swholmstead/ForkLift/README.md

<h1>3D printed RC Fork Lift</h1>
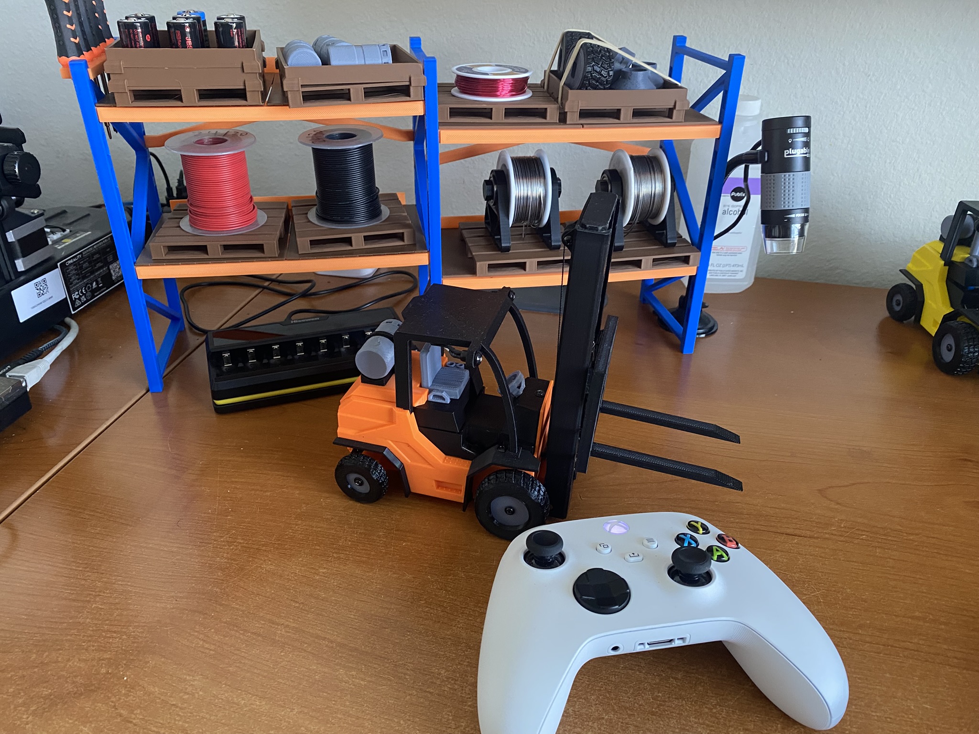
[picture p1: pictures/IMG_3393.JPEG]
Skidsteer


<h2>Table of Contents</h2>

* [3D Models](https://www.printables.com/model/1189510-3d-printed-rc-forklift-updated)
* [Bill of Materials](docs/bom.md)
* [Schematic and Printed Circuit Board](docs/schematics.md)
* [Assembly Instructions](docs/assembly.md)
* [Arduino IDE and Software](docs/arduino.md)

List of supported game controllers can be found here: [https://bluepad32.readthedocs.io/en/latest/supported_gamepads/](https://bluepad32.readthedocs.io/en/latest/supported_gamepads/)
