swholmstead/ForkLift/pictures/IMG_3504.JPEG

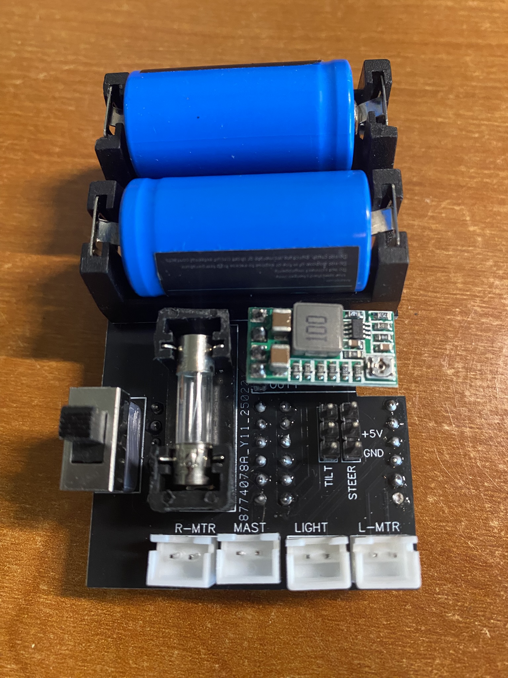
pictures/IMG_3504.JPEG
