swholmstead/ForkLift/docs/bom.md

<h2>Bill of Materials</h2>

All of these components are common and can be found online. I have provided links to Amazon and AliExpress, but these vendors may change over time. If the links don't work, just search for the components from wherever you shop.

* ESP32 WROOM-32 Development Board [Amazon](https://www.amazon.com/dp/B08D5ZD528) [AliExpress](https://www.aliexpress.us/item/3256805767190776.html)
    * This is available with micro USB or USB-C.  Get the one that you like.
* N20 12V 100 RPM motors (qty 3) [Amazon](https://www.amazon.com/gp/product/B0B8DB6NC8) [AliExpress](https://www.aliexpress.us/item/3256806632632389.html)
* 106-2RS bearings 6mm x 10mm (qty 2) [Amazon](https://www.amazon.com/gp/product/B082PPH3Z2)
* 85-2RS bearings 5mm x 8mm (qty 4) [Amazon](https://www.amazon.com/gp/product/B082PRTDZ9)
* 9g Micro Servo (qty 2) - available in metal or plastic.  Both work fine, but metal costs more but is more durable.
    *  SG90 (plastic) [Amazon](https://www.amazon.com/dp/B07Q6JGWNV) [AliExpress](https://www.aliexpress.us/item/3256806097043668.html)
    *  MG90S (metal) [Amazon](https://www.amazon.com/dp/B09BV5D7MD) [AliExpress](https://www.aliexpress.us/item/3256807333354770.html)
* 5V Buck Converter [Amazon](https://www.amazon.com/dp/B0DGPZ91BD) [AliExpress](https://www.aliexpress.us/item/3256807692095306.html)
* DRV8833 H-bridge (qty 2) [Amazon](https://www.amazon.com/dp/B0DB8CX8LK) [AliExpress](https://www.aliexpress.us/item/3256806096142480.html)
* JST-XH connectors (qty 4) [Amazon](https://www.amazon.com/dp/B0D6KSMK1Q) [AliExpress](https://www.aliexpress.us/item/2251832479273592.html)
* SS12D10 SPDT micro slide switch [Amazon](https://www.amazon.com/gp/product/B09R41P1JF) [AliExpress](https://www.aliexpress.us/item/2255800493933955.html)
* PCB Headers 2.54mm pitch [Amazon](https://www.amazon.com/2-54MM-Breakaway-Connector-Arduino-Prototype/dp/B08DVGCTKT) [AliExpress](https://www.aliexpress.us/item/2255800687544049.html)
* BLX-A Fuse holder 5mm x 20mm  (qty 1) [Amazon](https://www.amazon.com/dp/B093FK3GB1) [AliExpress](https://www.aliexpress.us/item/3256808172588255.html)
* 5A Fast-blow fuse 5mm x 20mm  (qty 1) [Amazon](https://www.amazon.com/dp/B07V5MYBL1) [AliExpress](https://www.aliexpress.us/item/3256803802728124.html)
* CR123a battery holder (qty 2) [Amazon](https://www.amazon.com/gp/product/B08RD1KQN3) [AliExpress](https://www.aliexpress.us/item/3256806203437629.html)
* CR123a rechargeable batteries (qty 2)
    * You can buy the batteries plus a charger [Amazon](https://www.amazon.com/dp/B0CF1SXDZ1)
    * Or get the ones with a built in charger [Amazon](https://www.amazon.com/dp/B0D3H7PBK8)
* 3mm 12V LED lights [Amazon](https://www.amazon.com/dp/B07T9KX9BP) [AliExpress](https://www.aliexpress.us/item/3256803264288460.html)
* 3mm LED holder [Amazon](https://www.amazon.com/dp/B07NRWLWCP) [AliExpress](https://www.aliexpress.us/item/3256803821521152.html)
* M2.6 x 6mm self-tapping pan head screws [Amazon](https://www.amazon.com/dp/B08QF455PJ) [AliExpress](https://www.aliexpress.us/item/3256806345826640.html)
* M2.6 x 8mm self-tapping pan head screws [Amazon](https://www.amazon.com/dp/B08QF455PJ) [AliExpress](https://www.aliexpress.us/item/3256806345826640.html)
* T270 or #277 or 840D upholstery thread for mast [Amazon](https://www.amazon.com/dp/B09NBCZLZY)
