swholmstead/ForkLift/docs/assembly.md

<h2>Assembly Instructions</h2>

<h3>Mast</h3>

Attach pulleys to mast sections with M2.6 x 6mm screws.  Ensure that pulleys swivel easily.  You may have to drill out outer holes to ensure that screws roll easily.

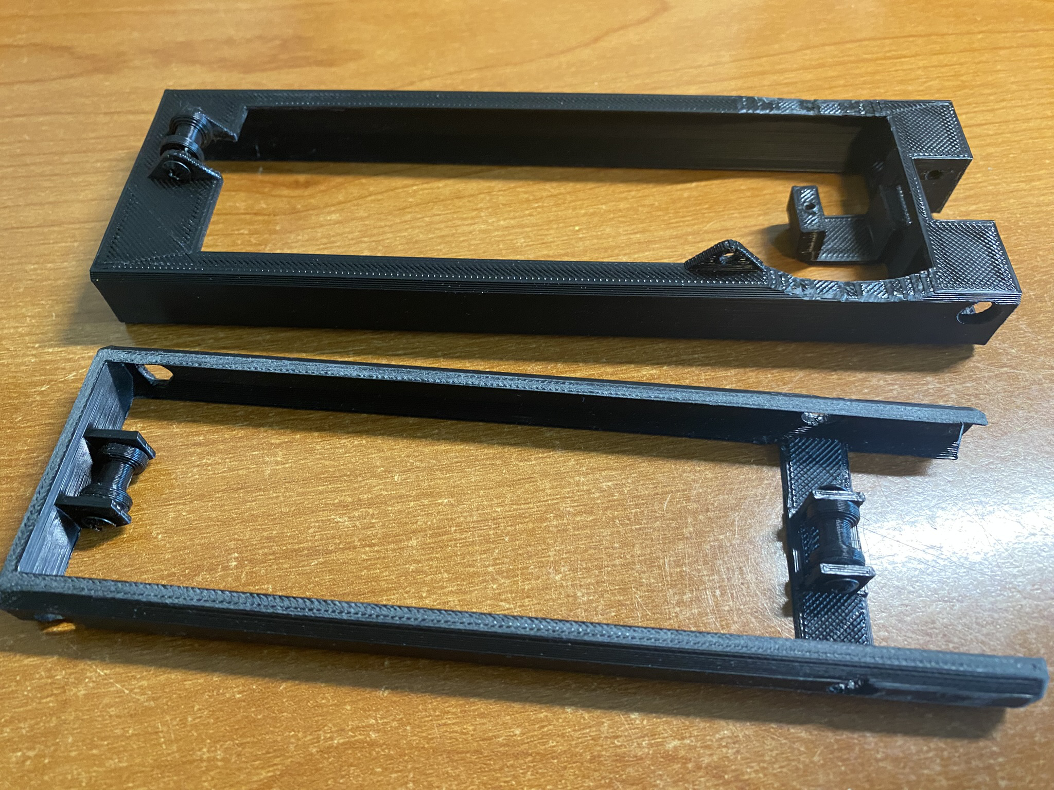
[picture p11: pictures/IMG_3515.JPEG]


Add 100mm of wire with JST-XH connector to N20 12V motor.  Push spool onto end of mast motor. Attach upholstery thread to spool.
Insert into mast and secure with mast motor lock and M2.6 x 6mm screw.

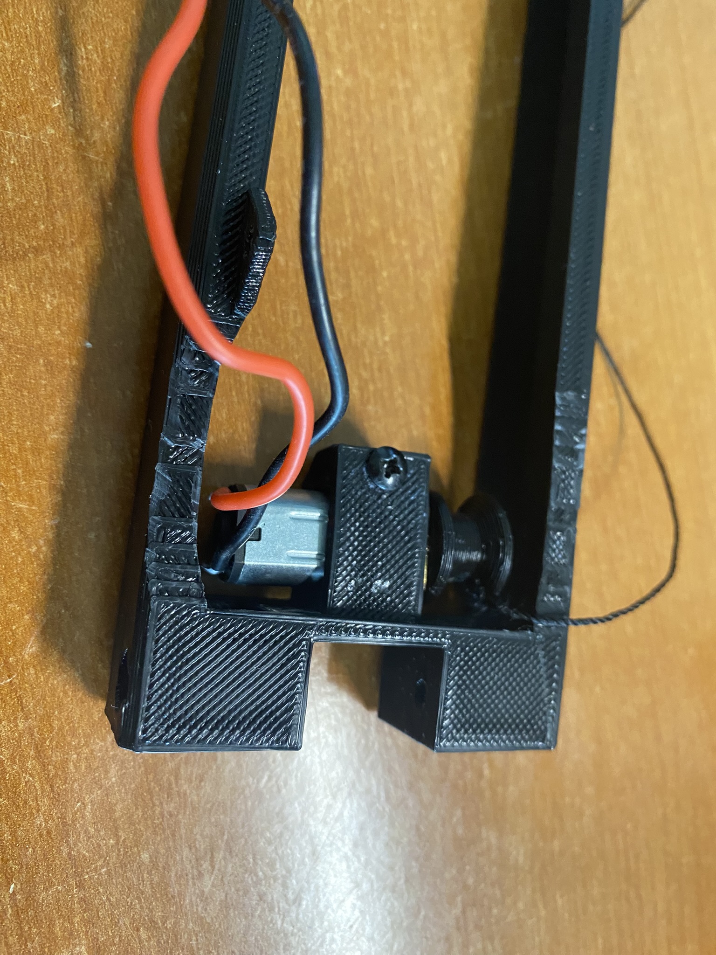
[picture p12: pictures/IMG_3516.JPEG]


Route upholstery thread through the pulleys as in illustration.  

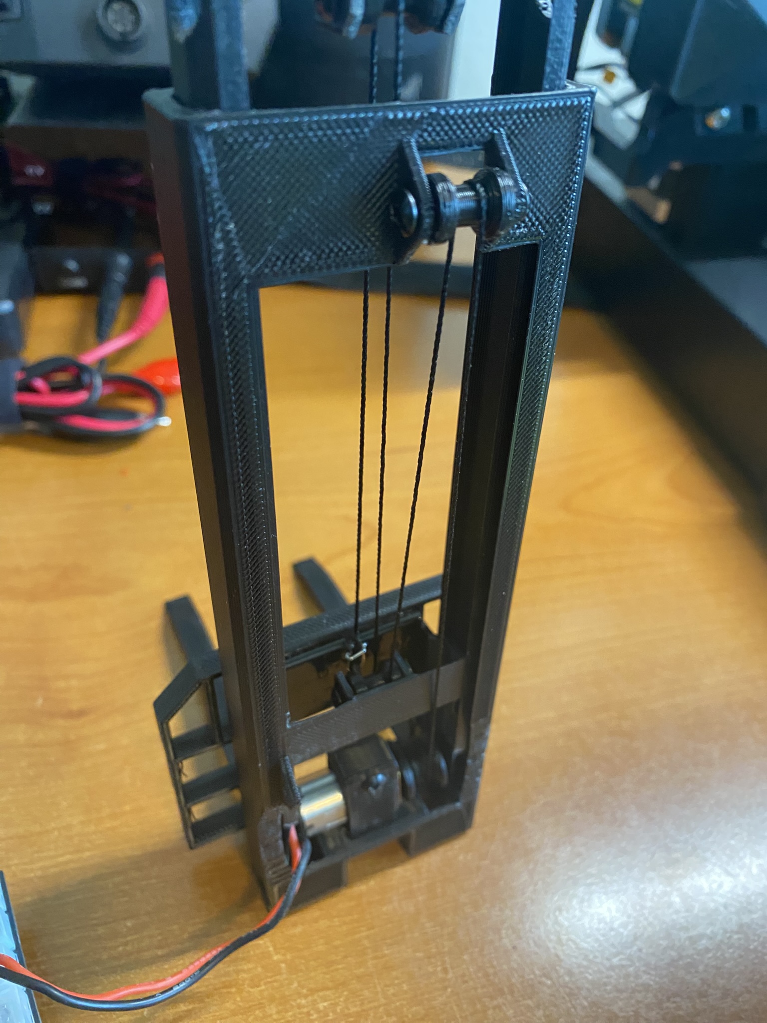
[picture p13: pictures/IMG_3518.JPEG]


I add some adhesive tire weights to the back of the carriage.  Attach upholstery thread.  I like to use a fishing clip for ease of use.

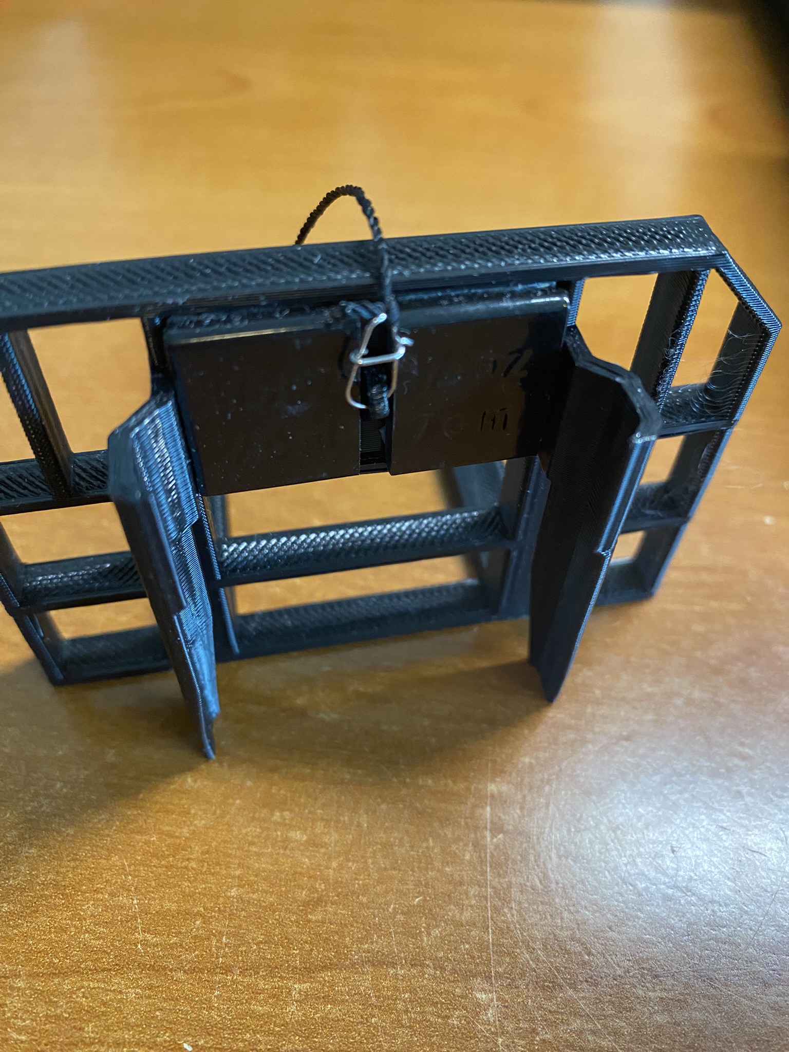
[picture p14: pictures/IMG_3517.JPEG]


Attach servo to front servo mount with mast linkage.

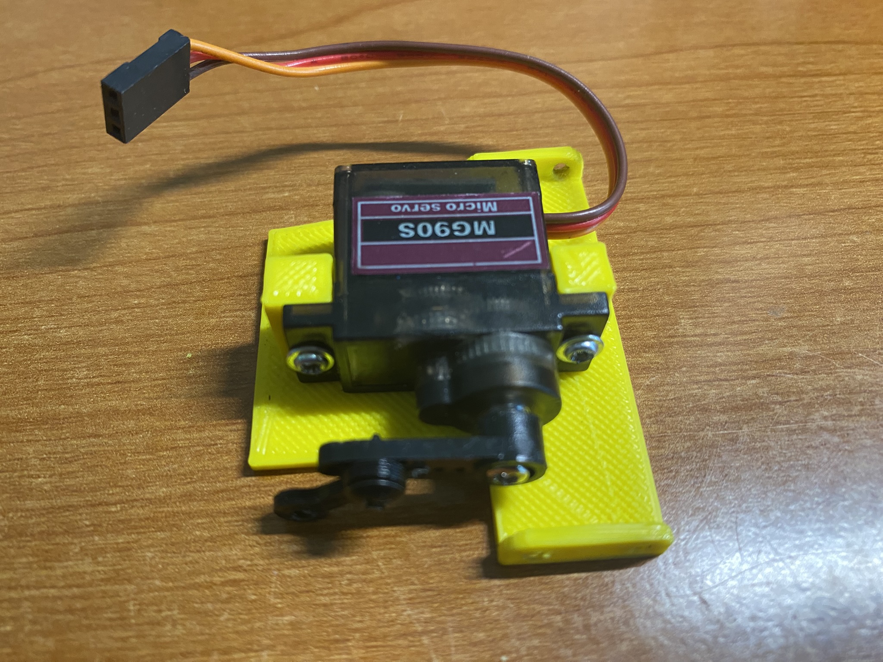
[picture p15: pictures/IMG_3513.JPEG]


<h2>Rear Cover</h2>

Attach seat to seat support and rear hatch with M2.6 x 6mm screws.  I like to add some adhesive tire weight to the rear cover to provide
conterbalance when forklift is lifting heavy objects.  Attach propane tank holder with TPU trap to outside of rear cover. Attach propane tank.

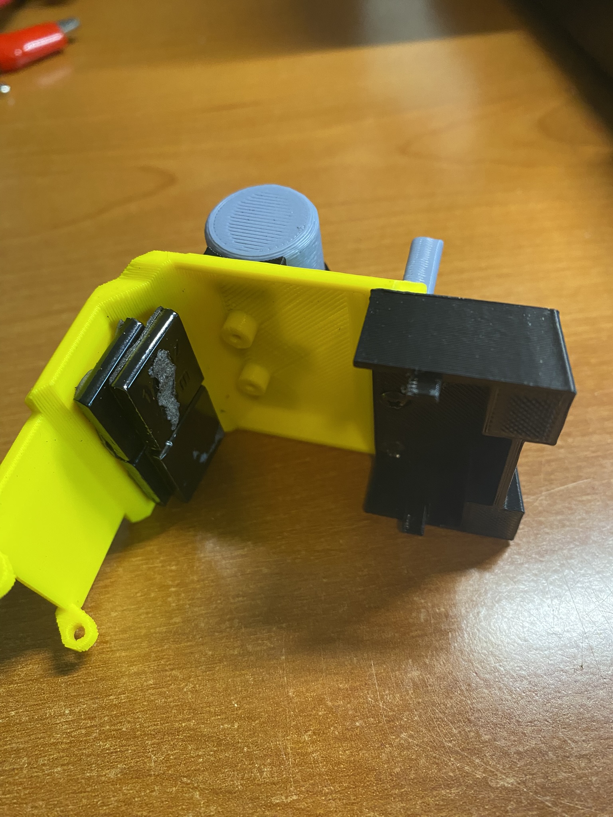
[picture p16: pictures/IMG_3506.JPEG]

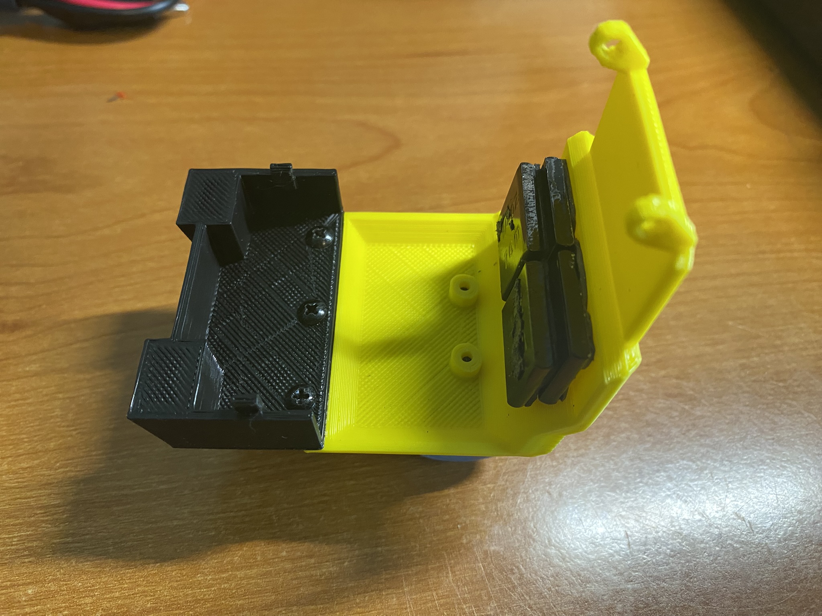
[picture p17: pictures/IMG_3514.JPEG]


<h2>Interior</h2>

Attach steering wheel to dash and attach dash to floor with M2.6 x 6mm screws.

<h2>Cab</h2>

Attach front and rear fenders with M2.6 x 6mm screws.

Add 100mm of wire with JST-XH connectors to N20 12V motors.  Secure in cab with motor lock and M2.6 x 6mm screw.

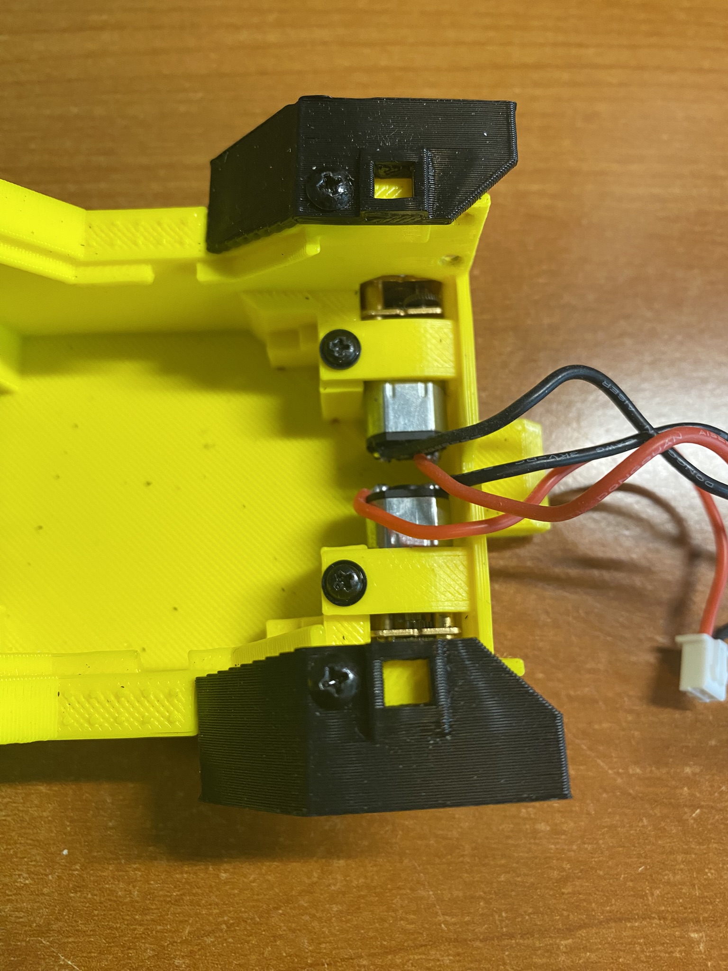
[picture p18: pictures/IMG_3507.JPEG]


Attach steering servo and servo arm to cab with screws including in servo kit. Push steering bar through side slots in cab 
and attach to servo with M2.6 x 6mm screws.

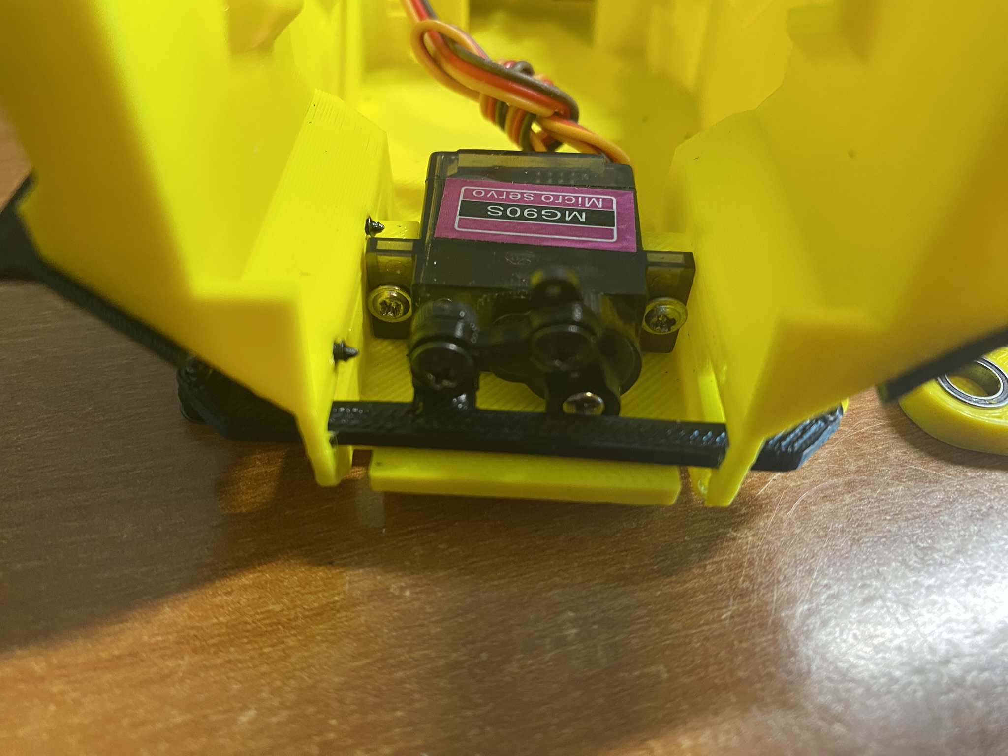
[picture p19: pictures/IMG_3509.JPEG]


Push 85-2RS 5mm x 8mm bearings into cab and wheel captures.

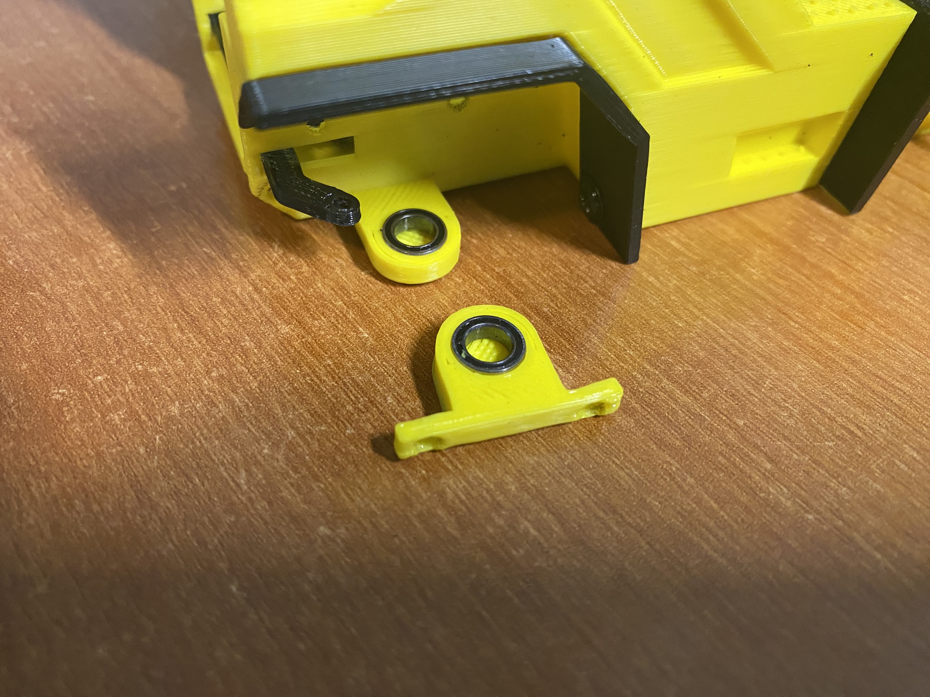
[picture p20: pictures/IMG_3508.JPEG]


Insert rear wheel pivot into bearing and attach to cab with wheel capture using M2.6 x 6mm screws.

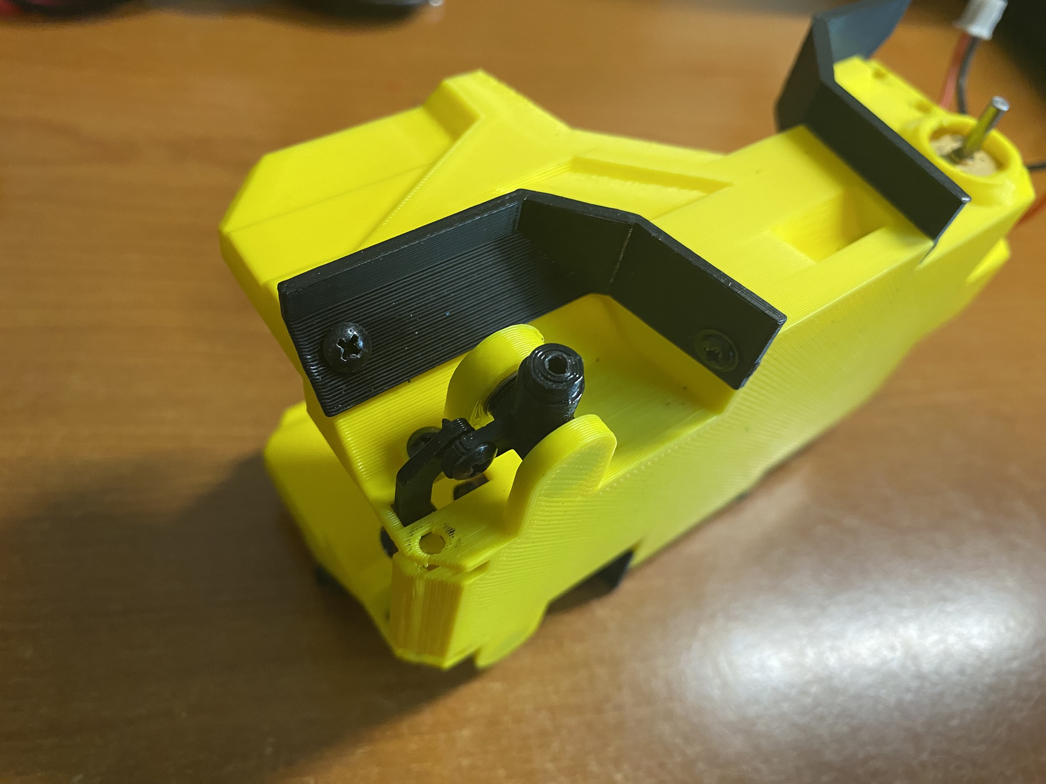
[picture p21: pictures/IMG_3510.JPEG]


Attach mast and front servo mount to cab with M2.6 x 6mm screws.  Ensure mast motor wires are routed through hole in front of servo mount.

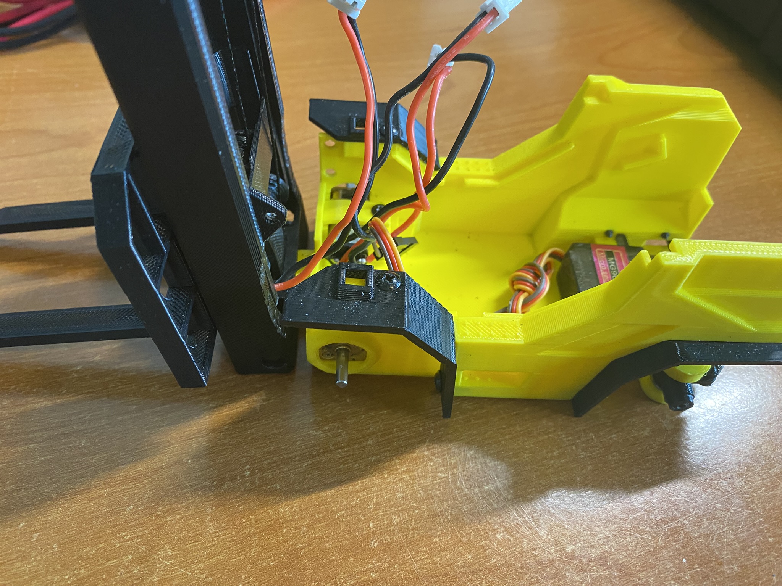
[picture p22: pictures/IMG_3519.JPEG]

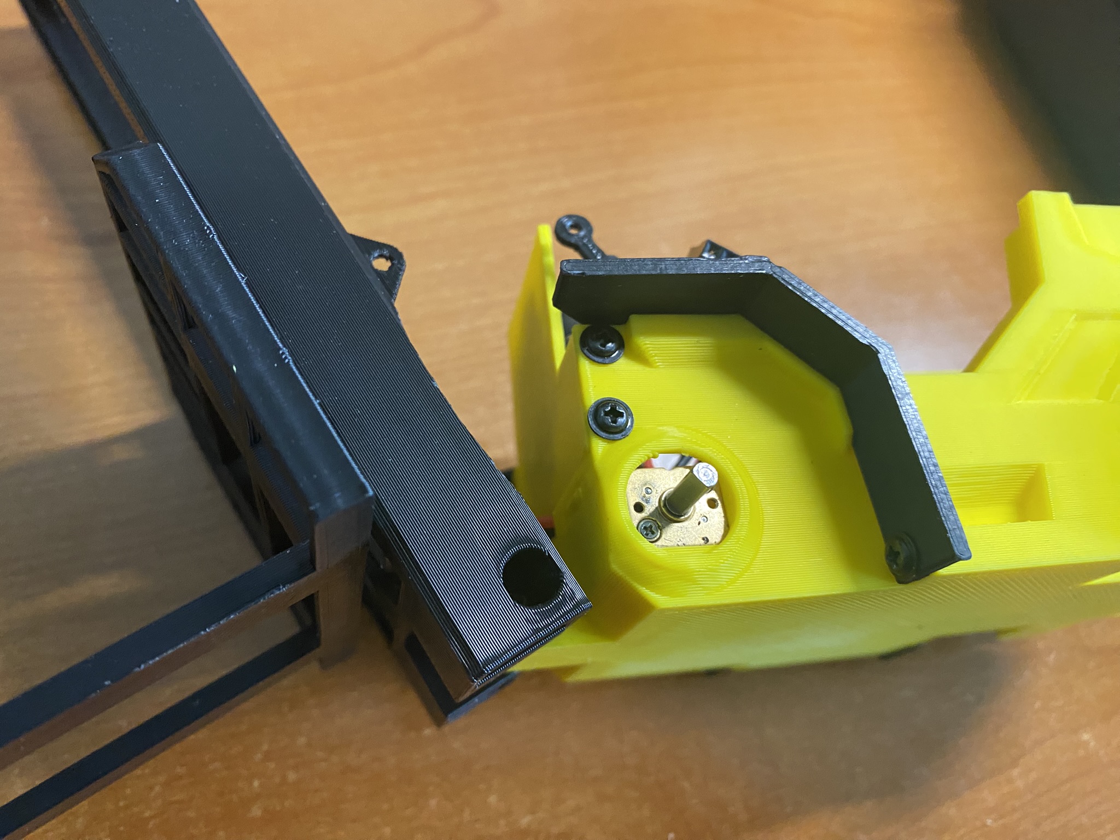
[picture p23: pictures/IMG_3520.JPEG]


Attach wires to electronics and fit inside of cab.

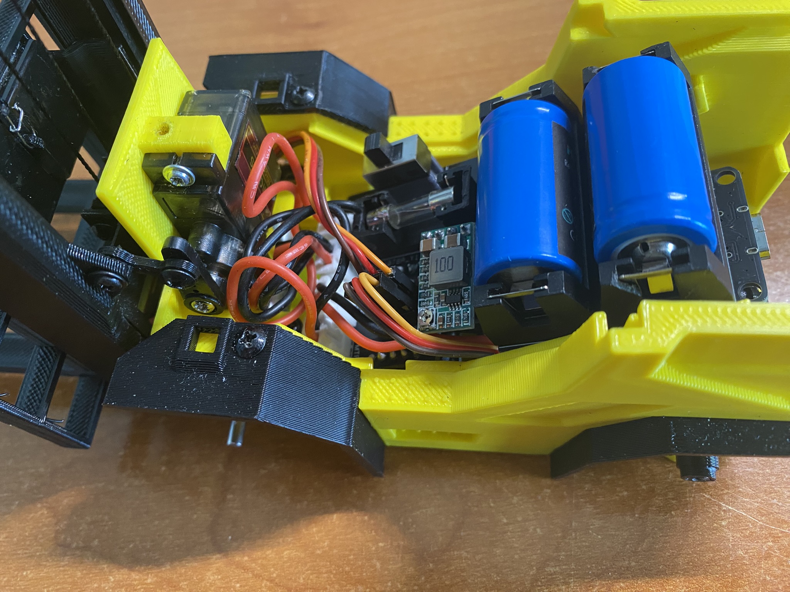
[picture p24: pictures/IMG_3521.JPEG]


<h2>Roll Cage</h2>

Attach LED lights and LED mounts to roll cage.  Route wires down slot in side of roll cage.

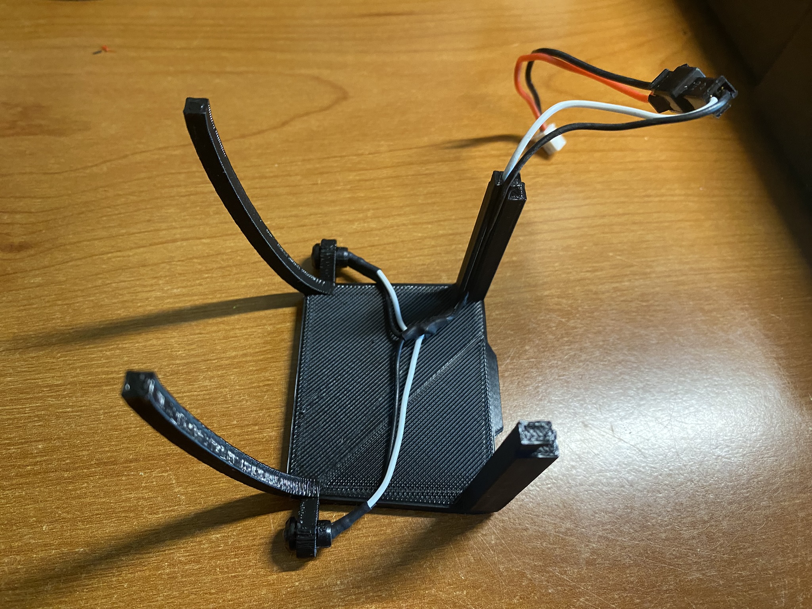
[picture p25: pictures/IMG_3511.JPEG]


<h2>Final Assembly</h2>

Press 106-2RS 6mm x 10mm bearings into rear wheels.  Attach tires to wheels.

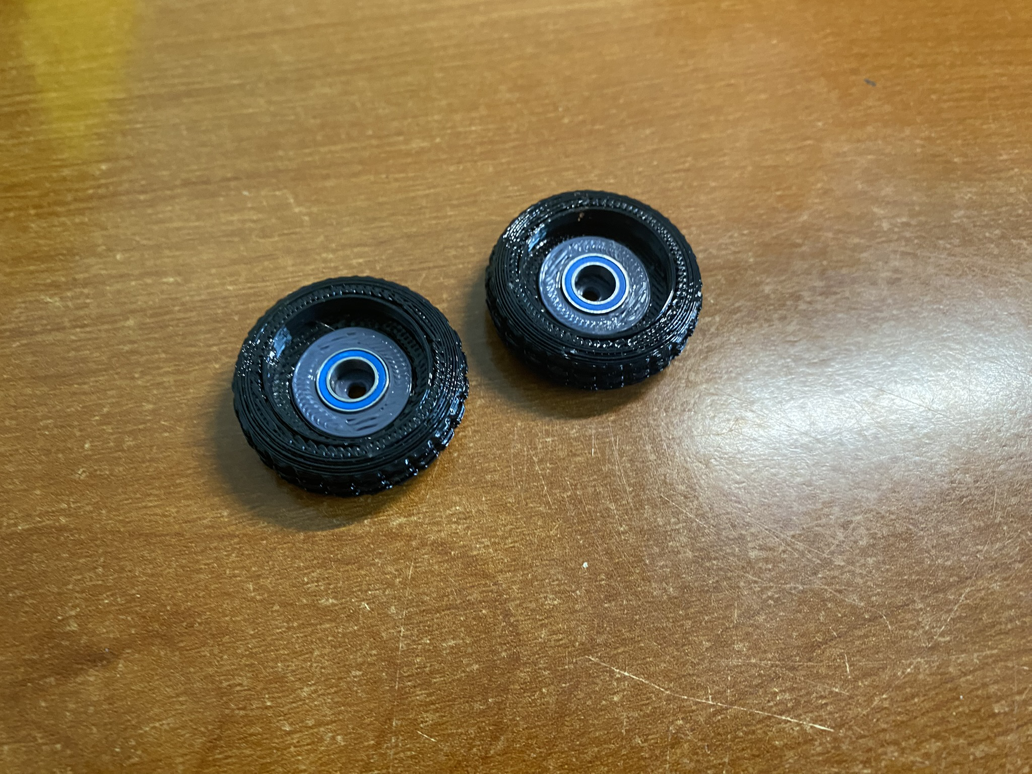
[picture p26: pictures/IMG_3525.JPEG]


Attach interior, rear cover, and roll cage to cab to complete assembly.

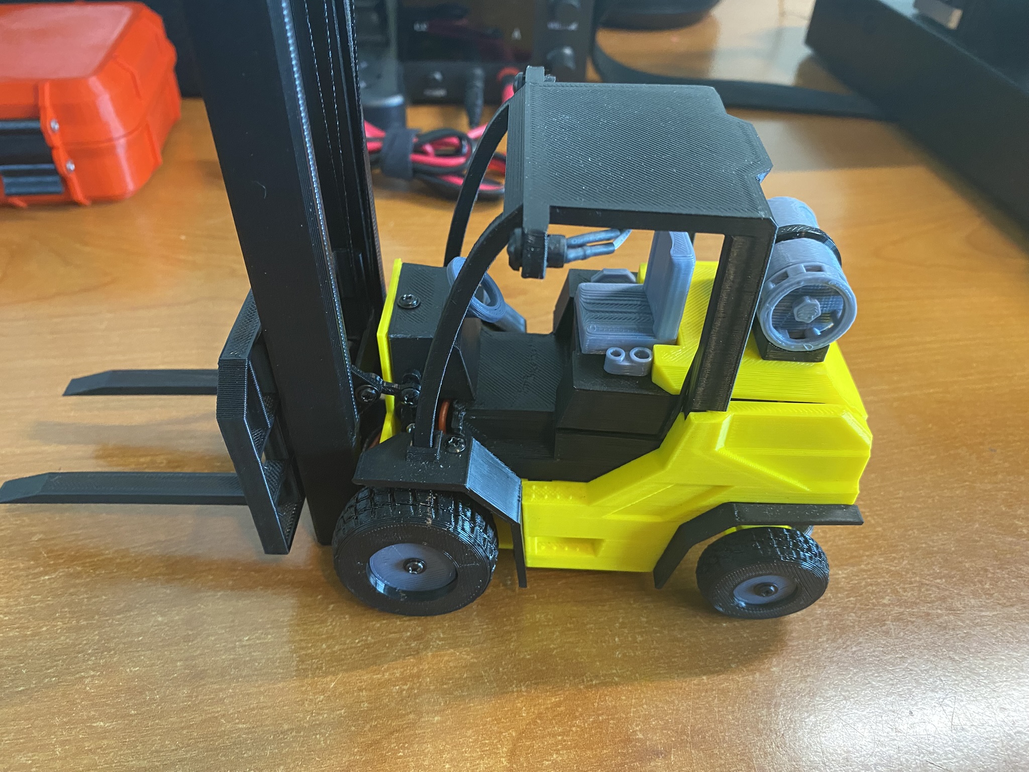
[picture p27: pictures/IMG_3526.JPEG]
