swholmstead/ForkLift/(threads)

Thread 1 (2025-03-10):

Some wrong sizes

meowboxie, 2025-03-10:
Hey just a heads up that both the front and rear wheels are 1mm too large for the tires, the 6700 2rs bearing holes are 2mm too small on the body and the front wheel shaft is 1mm too large for the 6700 2rs bearing. Other than that so far it seems pretty good, I'm using your remixed files for a build that will just use a normal FS-i6s RC transmitter and receiver using a couple mini esc's and hopefully fit a couple 18650 cells since I already have a bunch of them harvested from old packs.

swholmstead, 2025-03-10:
I updated the front and rear wheels to make them 1mm smaller, but then added traction bars so the tires would not slip.

swholmstead, 2025-03-14:
Correct.

The frame and wheel captures use the 85-2RS bearings 5mm x 8mm.
The wheel uses the 106-2RS bearings 6mm x 10mm.

Closed 2025-08-30.

Thread 2 (2025-03-11):

BOM question

podhal, 2025-03-11:
Hi, this is from complete newbie ordering his first PCB from PCBWay. But what is the name of connectors you have to soldier to pcb where You actually plug in ESP32 and drivers?

swholmstead, 2025-03-11:
Those a 2.54mm headers.  You need both male and female.  I added them to the BOM.  Thats for catching this.

PCB Headers 2.54mm pitch [Amazon](https://www.amazon.com/2-54MM-Breakaway-Connector-Arduino-Prototype/dp/B08DVGCTKT) [AliExpress](https://www.aliexpress.us/item/2255800687544049.html)

Closed 2025-03-11.

Thread 3 (2025-03-27):

switch/toggle missing in bom

pingi27, 2025-03-27:
It seems to me the additional switch/toggle is missing in the bom. Would be nice to add.

swholmstead, 2025-03-27:
Fixed.  It has been added to the BOM.

* SS12D10 SPDT micro slide switch [Amazon](https://www.amazon.com/gp/product/B09R41P1JF) [AliExpress](https://www.aliexpress.us/item/2255800493933955.html)

pingi27, 2025-03-27:
Closed

Closed 2025-03-27.
