swholmstead/ForkLift/(commit log)

2025-01-27 Create Gerber Forklift PCB.zip
2025-01-28 Disallow multiple BT connections
    Prevent multiple controllers from connecting to the same vehicle.
    [MiniFork_Bluepad3.0.ino]
2025-02-01 Added wire routing
2025-02-12 Update Gerber Forklift PCB.zip
2025-02-20 Limit steering rate
2025-02-21 Switched pins for new PCB
2025-02-22 Organized files, add BOM
2025-03-10 Added assembly pictures
2025-03-14 Removed 6700-2RS bearings from BOM
2025-09-10 Added picture checking +5V
